midoribaka/gsm/README.md

**GSM alarm system on PIC 16F628A.**

Документация находится в [вики.](https://github.com/midoribaka/gsm/wiki)
