midoribaka/gsm/main/sch.pdf

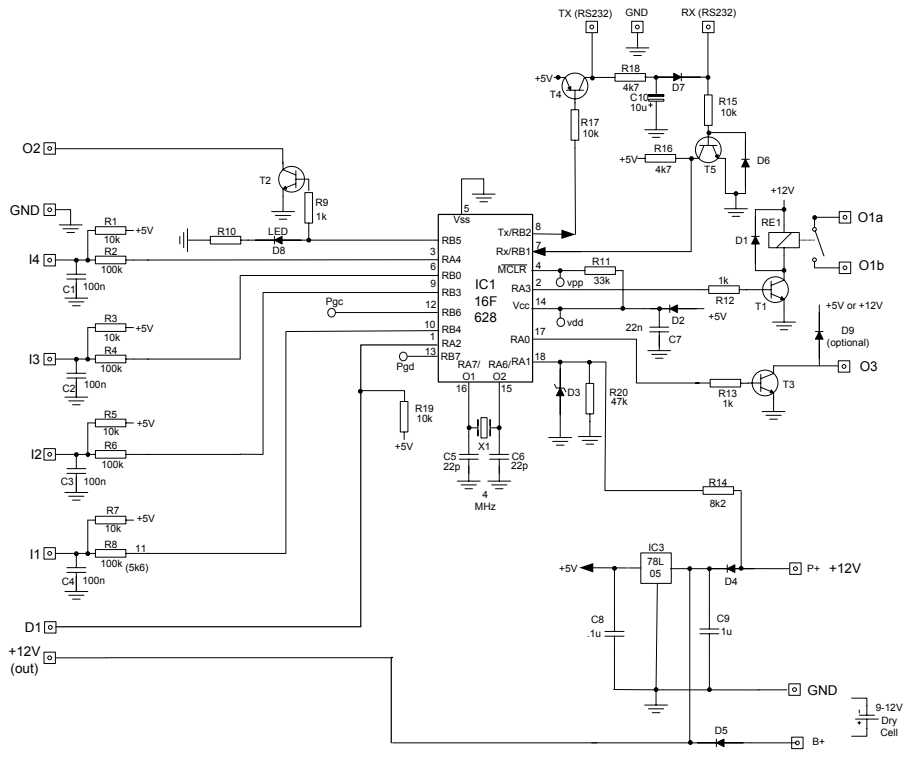
[picture p1: page 1]
MCLR; Vcc; Vss; RlE; RAby Ol; RAay OE; ICl laF aEi; EEp; S MHz; leen; biL e.; lek; leek; PlEV Boutv; GND; TxyRBE; RxyRBl; RBa; RBb; Rll; vpp; vdd; Pgd; Pgc; RlS; ikE; B.kav; &-lEV Dry Cell; EEn; PlEV; REl; leu; TXTBRSE Ev GND; RXTBRSE Ev; Cle; Rli; Rla; Rlb; Skb; Ci rlu; Rle; LED; Ola; Olb; RAS; RBe; RBS; RAE; RAe; RAl; GSM-SIOS SupervisionTNTControl SystemTvrlre; ©TEeeiTyTowdkBatvyahoorcom; D& Boptionalv; P.VTorTPlEV; Rl& lek; REe Sbk
