midoribaka/gsm/main/gerber/solderside_layout.pdf

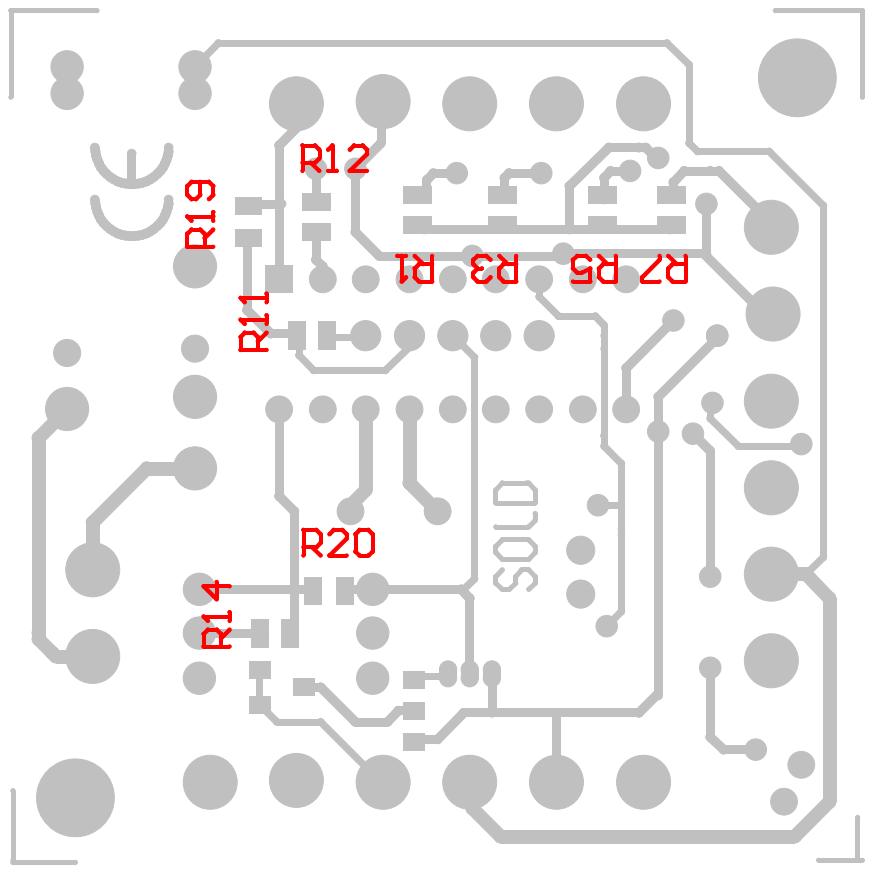
[picture p2: page 1]
