midoribaka/gsm/main/gerber/compside_layout.pdf

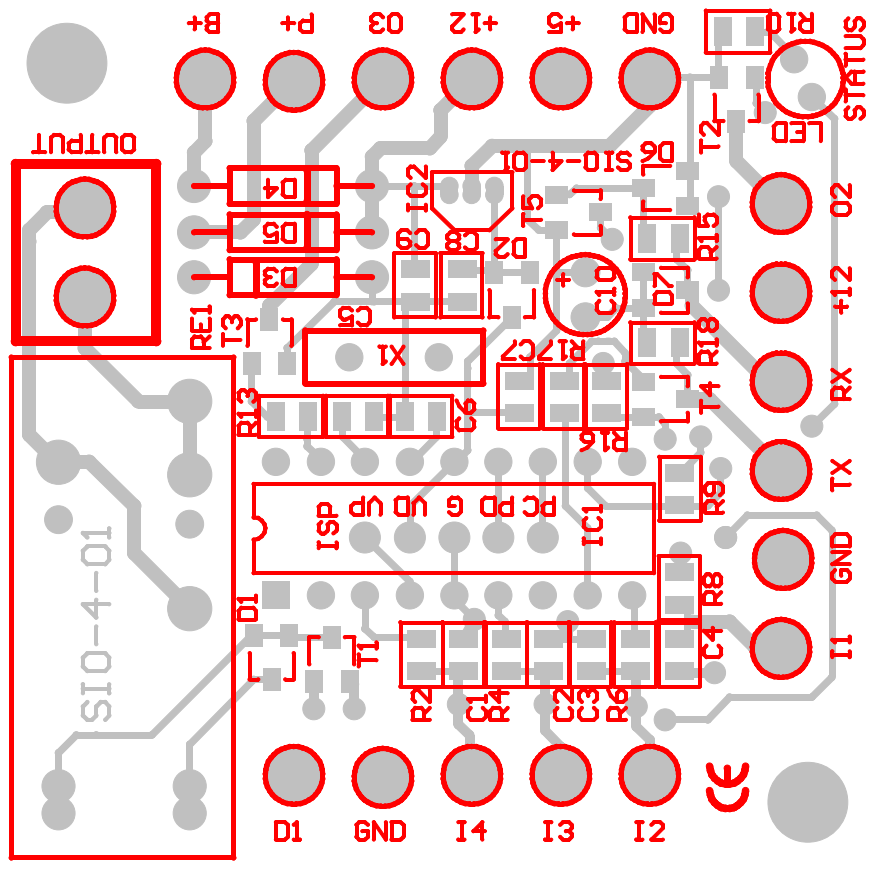
[picture p3: page 1]
