midoribaka/gsm/(commit log)

2014-03-10 Добавил исходники прошивки
2014-03-10 Revert "Добавил исходники прошивки"
    This reverts commit 5e48872e57703b1ce0790868747809d0bad82d17.
2014-03-10 Исходники прошивки
2014-03-10 Update README.md
    Добавил принцип работы
2014-03-10 Update gsm.asm
    Поменял кодировку, теперь кириллица читабельна.
2014-03-10 Добавил схему.
2014-03-10 Добавил схему
2014-03-10 Сменил кодировку
2014-03-10 Update gsm.asm
    В очередной раз сменил кодировку
2014-03-10 Update gsm.asm
    Опять кодировка
2014-03-10 Документация и примеры
2014-03-10 Main branch
    [SIO4-01.DRL, SIO4-01.GBL, SIO4-01.GBO, SIO4-01.GBS, SIO4-01.GTL, SIO4-01.GTO, SIO4-01.GTS]
2014-03-10 Блок-схема работы сигнализации
2014-03-10 Update source.bas
    Пофиксил хидер
2014-03-10 Update README.md
    Добавил ссылку на todo list
2014-03-10 Переименовал "documentation" в "docs"
2014-03-10 Переименовал папку
2014-03-10 Update README.md
    Изменил размер заголовка
2014-03-10 Убрал текстовый блок с pdf
2014-03-11 Принципиальная схема
2014-03-11 Update source.bas
    Удалил лишние переносы
2014-03-11 Вычитка и окончательная редактура исходников
2014-03-13 Пофиксил принципиальную схему. Набросал каркас отчета.
2014-03-16 Немного дописал док
2014-03-17 Добавил введение
2014-03-17 Добавил введение [2]
2014-03-17 Добавил немного к описанию
2014-03-17 Добавил пару абзацев к описанию
2014-03-18 Небольшие фиксы
2014-03-18 Правки
2014-03-21 Окончательные правки
